dwblair/riffle-turbidity/pics/ad820.png

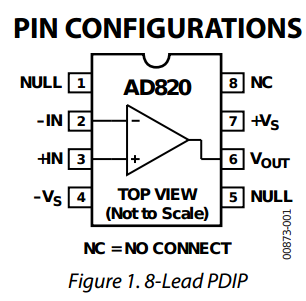
pics/ad820.png
