dwblair/riffle-turbidity/pics/ref1_comparison.png

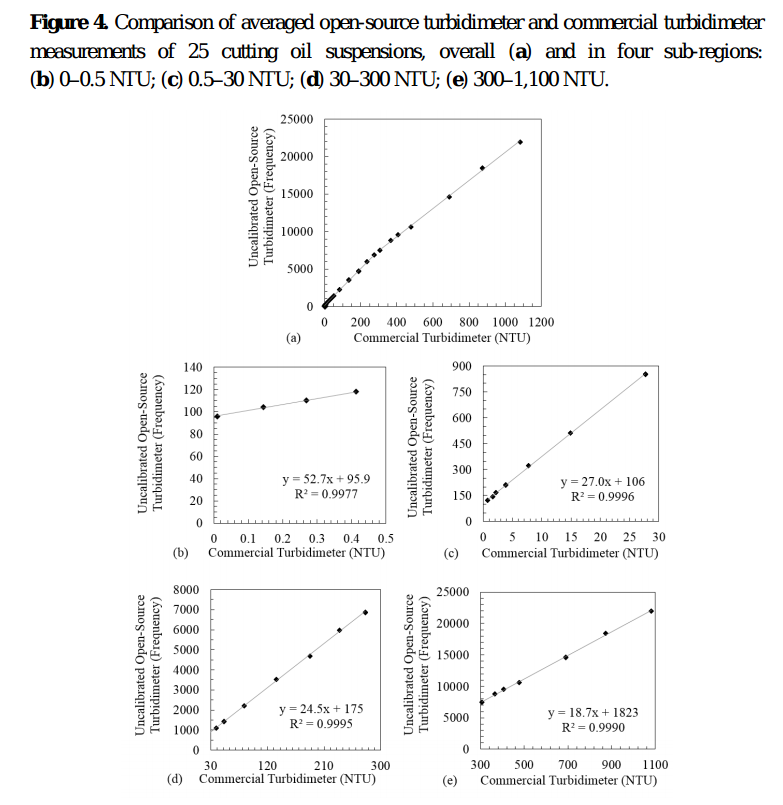
pics/ref1_comparison.png
