dwblair/riffle-turbidity/pics/ref3_comparison.png

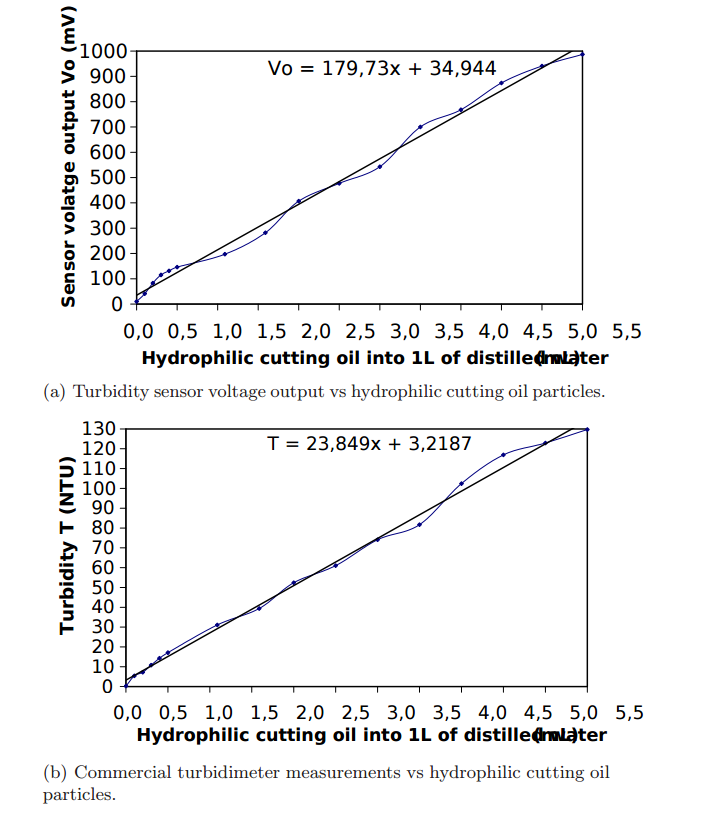
pics/ref3_comparison.png
