dwblair/riffle-turbidity/schematic/riffle-turbidity.sch

## EAGLE design schematic/riffle-turbidity.sch (2016-08-26)

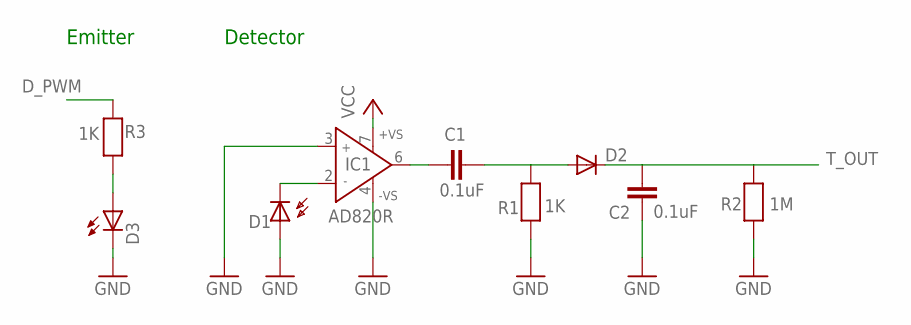
[picture p12: schematic riffle-turbidity.sch]

Parts:
C1, C2: 0.1uF; 0603-CAP
D1: BPX65
D2: 1N4148DO35-7; DO35-7
D3: LZ1-00WW03
IC1: AD820R; SO8
R1, R3: 1K; 0603-NO
R2: 1M; 0603-NO

Connections:
D_PWM: R3.1
GND: C2.1, D1.A, D3.1 (C), IC1.3 (IN+), IC1.4 (-VS), R1.1, R2.1
unnamed: D1.K (C), IC1.2 (IN-)
unnamed: C1.2, IC1.6 (OUT)
unnamed: C1.1, D2.A, R1.2
unnamed: D3.2 (A), R3.2
T_OUT: C2.2, D2.C, R2.2
VCC: IC1.7 (+VS)

Notes on the sheet:
Emitter
Detector
