dwblair/riffle-turbidity/(threads)

Thread 1 (2016-10-16):

Purpose of diode

wicker, 2016-10-16:
Hi! Possibly a silly question, but the diode D2 isn't listed in the required parts and there's no information about its purpose. Were there particular characteristics it should be selected for? Is it an important part of the filter or is it primarily providing reverse voltage protection?

dwblair, 2016-10-16:
Ah, definitely not a silly question!

The on/off square wave of the emitter induces an on/off square wave signal in the detector diode D1, which is amplified through the op-amp.

The op-amp thus puts out an oscillatory signal ... which passes through R1 and C1 ... which form a [high pass filter](https://en.wikipedia.org/wiki/High-pass_filter), the frequency cut off of which should be chosen to be sufficiently below the oscillation frequency that this oscillation is allowed through, but lower frequency signals (like ambient light fluctuations) are blocked.

Because of the capacitive coupling at C1, the oscillation on the other side goes above and below zero volts.  D2 is then placed in line in order to block the negative part of the signal (so that ultimately we can measure the signal with the ADC on the microcontroller, which wants to see something between 0 and VCC).

I need to revisit the next part of the circuit to remember what I was trying to do there :)  My first thought is that I wanted a [low-pass filter](https://en.wikipedia.org/wiki/Low-pass_filter), so that we end up with a non-oscillatory signal proportional to the amplitude of the incoming oscillation.  But then I would expect R2 to be in line with signal, not going to ground?  I might've goofed ... I'll dig up my notes.  Thanks for pinging about this!

wicker, 2016-10-16:
Thanks for the quick and thorough response!

I've got four sensors (coqui, temperature, depth, and this one) prototyped on a breadboard, and I'm trying to get a sense for the data into an Atmega328 breakout board. I'll hopefully also have something to contribute shortly. :)

dwblair, 2016-10-16:
Oh, fantastic --  I'm really appreciating having another set of eyes on these circuits, it's really great!

I'll say in advance -- the coqui circuit doesn't seem to do a great job measuring conductivity, and we eventually discovered that it's not a very good approach.  Other circuits listed in the 'conductivity' repo are more promising, I think.  But it's still a fun circuit to play with, and get a sense for how conductivity works ...

wicker, 2016-10-16:
In the interest of getting a whole package in the water, I'm actually thinking I may go with the [EZO conductivity kit from Atlassian](http://www.atlas-scientific.com/product_pages/circuits/ezo_ec.html), despite the relatively higher cost. Then, when I'm a bit more experienced and have read through the giant and excellent list of references on the conductivity repo, I could build the other circuits and compare to a calibrated EZO and have a better idea of what will survive in an actual long-term deployment.

Have you had any experience with those EZO units?
